OilSlick/soil_sensor_socr/.github/images/calibrating.jpeg

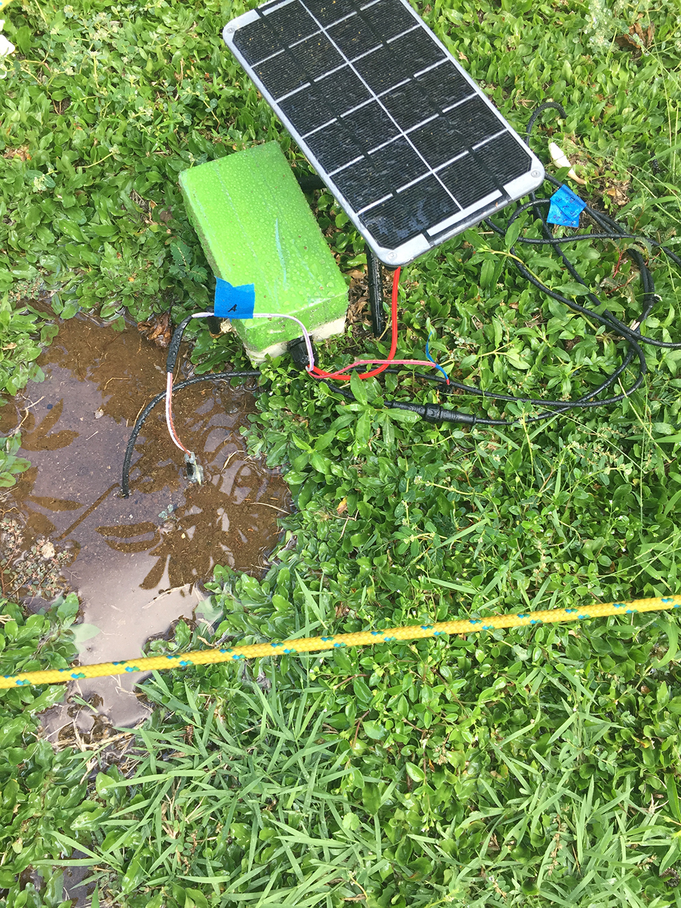
.github/images/calibrating.jpeg
