OilSlick/soil_sensor_socr/.github/images/calibrating1.jpeg

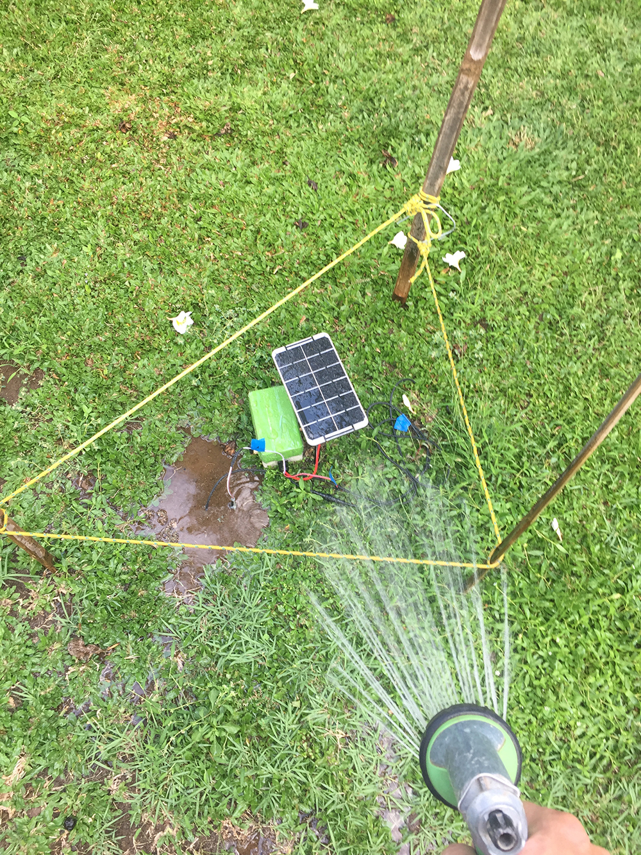
.github/images/calibrating1.jpeg
