OilSlick/soil_sensor_socr/.github/images/corrosion1.jpeg

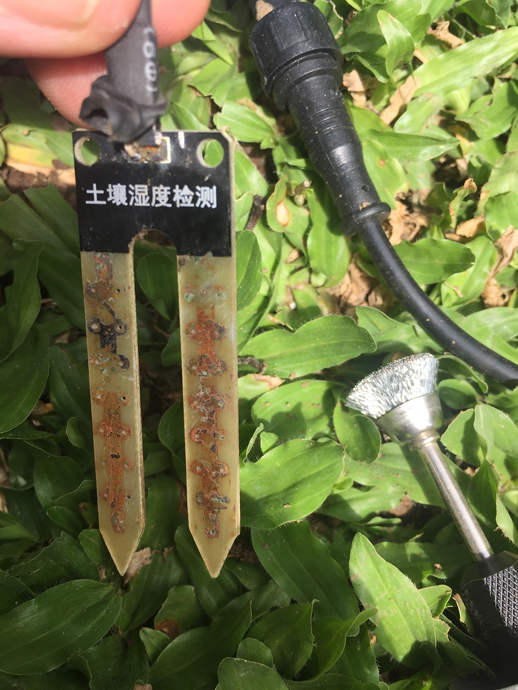
.github/images/corrosion1.jpeg
