OilSlick/soil_sensor_socr/.github/images/corrosion.jpeg

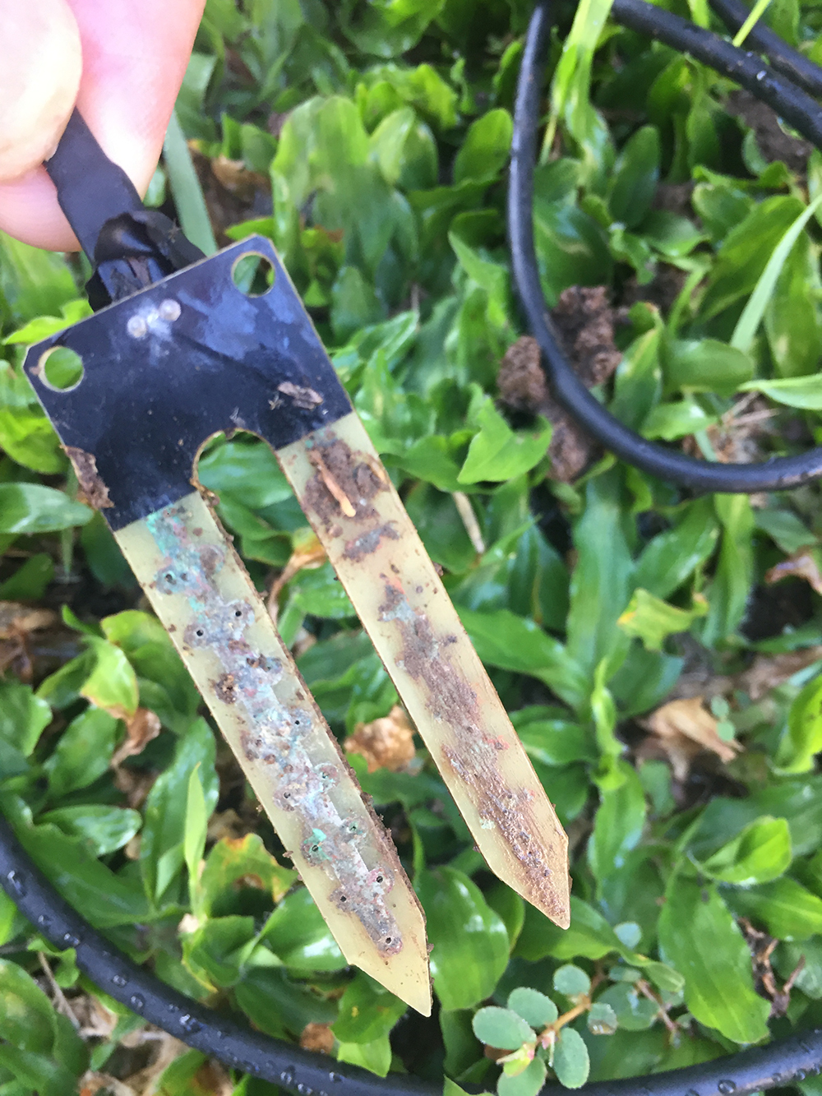
.github/images/corrosion.jpeg
