OilSlick/soil_sensor_socr/.github/images/heat.jpeg

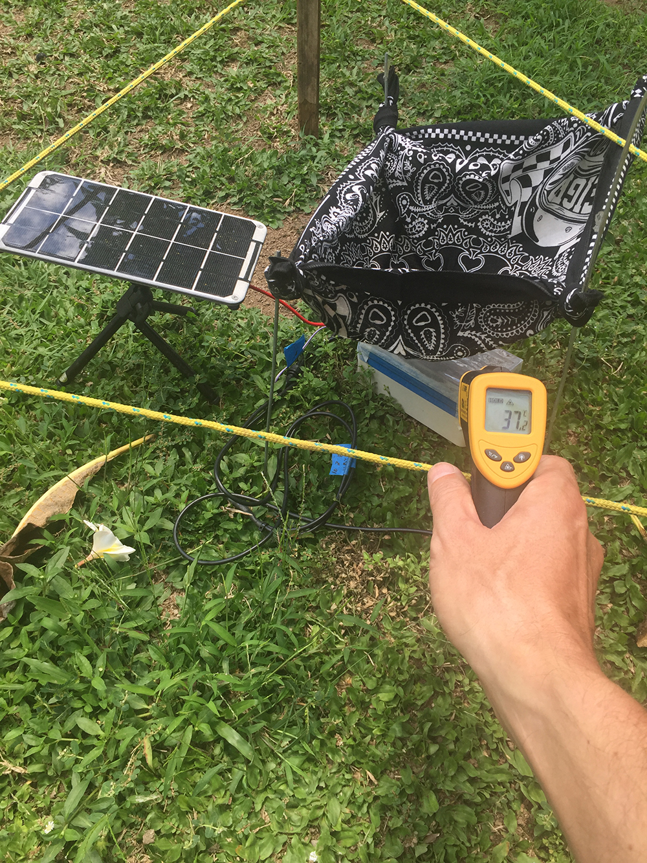
.github/images/heat.jpeg
