OilSlick/soil_sensor_socr/.github/images/over-voltage.png

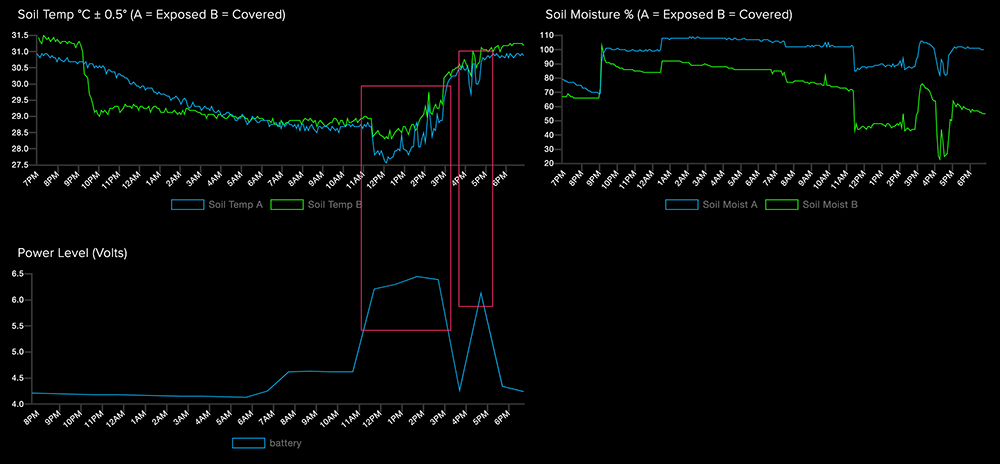
.github/images/over-voltage.png
