OilSlick/soil_sensor_socr/.github/images/probe-post1.jpeg

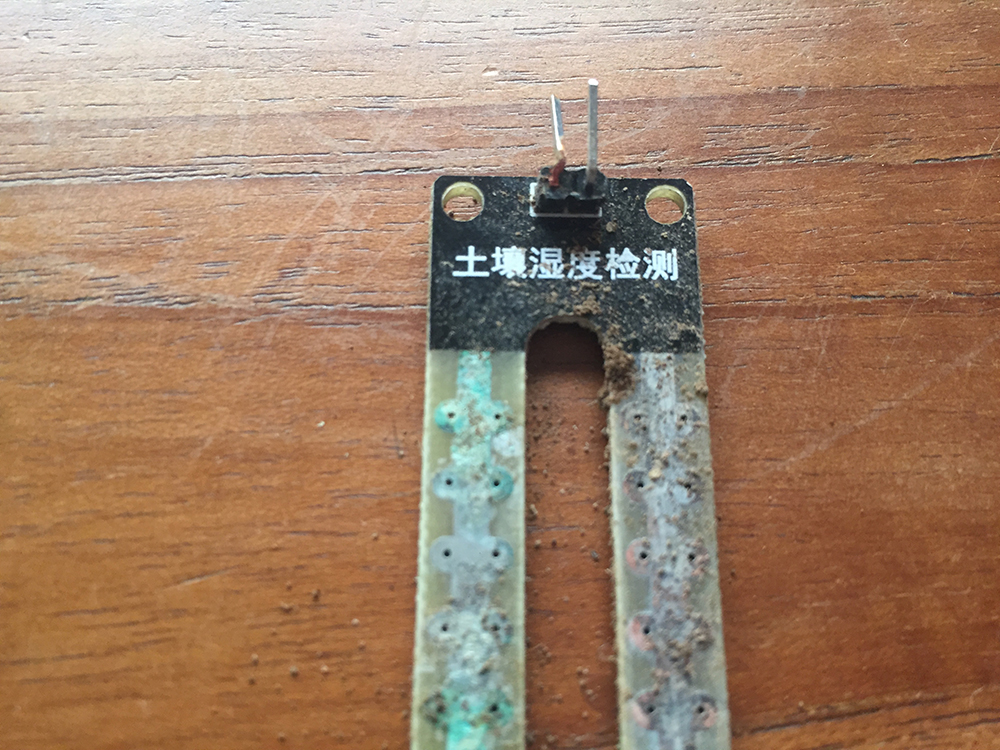
.github/images/probe-post1.jpeg
