OilSlick/soil_sensor_socr/.github/images/probe-post.jpeg

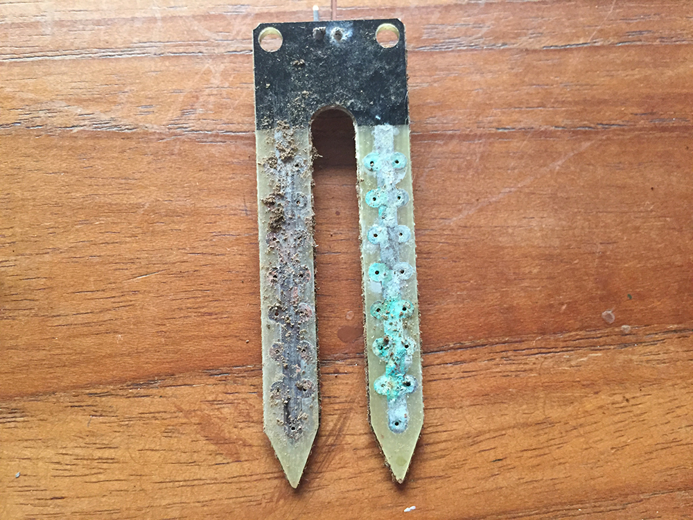
.github/images/probe-post.jpeg
