OilSlick/soil_sensor_socr/(threads)

Thread 1 (2020-03-20):

Reduce LoRa transmission

OilSlick, 2020-03-20:
Consider combining temp and moisture data tx into one, such as Temp and Moist A data as one transmission.

Transmission increases (almost doubles) the power consumption.

OilSlick, 2020-03-22:
I could also reduce the 12-byte payload being sent, as the temperature data is only 2 of those 12 bytes.

But I don't think I'll do either, because that would require me to take the sensor out of production to make the changes and that will affect data-collection and since this is a school project and the data is what I need, I'll likely just leave it as-is.

OilSlick, 2020-04-02:
I've decided to leave the transmissions as-is for now to 1) save time and get some freakin' data and 2) I would need to re-do how the web-gateway receives and interprets the data.

I may revisit this later, if I chose to deploy something like this sensor long-term (this is for a school project and won't necessarily be  needed after the semester is over.

Closed 2020-04-02.

Thread 3 (2020-03-26):

Check for reasonable values, discard unreasonable values

OilSlick, 2020-03-26:
Make sure all returned sensor values are within reasonable ranges and if not, discard them before transmitting.

OilSlick, 2020-03-29:
Just read about constrain() on this forum: https://forum.arduino.cc/index.php?topic=330634.0

https://www.arduino.cc/reference/en/language/functions/math/constrain/

OilSlick, 2020-04-02:
Have applied constrain() at the web gateway to all four probes, before it sends data to io.Adafruit

Closed 2020-04-02.

Thread 4 (2020-03-30):

Hardware: with full sun the unit reports erratic readings

OilSlick, 2020-03-30:
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

With full sun (and a full 6v from the solar panel) the values from all four sensors become erratic and generally lower.

Providing shade for the unit as a test point strongly towards over-power as the likely cause.

See also: [this Twitter thread](https://twitter.com/OilSlickCoffee/status/1243020344031473665?s=20)

OilSlick, 2020-04-02:
Installed an LM4931 LDO regulator between the LiPo charger and the microcontroller. That corrected the problem.

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

Closed 2020-04-02.

Thread 5 (2020-05-02):

Water damage

OilSlick, 2020-05-02:
It's a sad day. The station stopped reporting yesterday morning shortly after 5a. After troubleshooting everything else, I opened the unit to find it had water in it and the LiPo charger was sitting in water.

I'm pretty sure the water got in at the cable gland. I did a good job of sealing everything with hot glue, but not the actual cables where they pass through the gland. So with the relatively harsh environment of direct, tropical sun all day and the occasional monsoon overnight (we had two good storms as I recall while the unit was deployed.

And to add while I had the unit out of the ground I checked the last functioning moisture probe and found that it was also significantly corroded to the point of inaccurate readings.

So after I let everything dry out, I'll remove the moisture sensors and see what is salvageable from the unit. I hope to redeploy it to a different location in the yard, just with better waterproofing this time.

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
