OilSlick/soil_sensor_socr/transmissions.ino

void broadcastdata(byte data[], int sizeofFullPayload, byte ProbeAddr) {
  delay(200);                           // may be needed?
  LoRa.beginPacket();                   // start packet
  LoRa.write(destination);              // add destination address
  LoRa.write(localAddress);             // add sender address
  LoRa.write(msgCount);                 // add message ID
  LoRa.write(sizeofFullPayload);        // add payload length
  LoRa.write(ProbeAddr);                // Probe Address
  LoRa.write(data, sizeofFullPayload);  // add payload
  LoRa.endPacket();                     // finish packet and send it
  msgCount++;                           // increment message ID
  memset(data, 0, sizeof(data)); //clear array

//  if ( debug == true && Serial ) displayDebug("broadcastMessage()");
  digitalWrite(RFM95_SS, HIGH);

  if ( Serial && debug == 1 )
  {
    Serial.println(" ");
    Serial.print("Size of payload after TX: ");
    Serial.println(sizeofFullPayload);
    Serial.print("Payload after TX: ");
  
    for ( i = 0; i < sizeofFullPayload; i++) 
        {
          Serial.print(data[i], HEX);
          Serial.print(" ");
        }
    Serial.println(" ");
  }
}
