OilSlick/soil_sensor_socr/(commit log)

2020-03-19 Add millis timer
2020-03-19 slow things down a bit
    Need to delay transmissions to allow for the data to get from this sensor to the web gateway for processing then transmitted to io.adafruit
2020-03-21 remove power pin
2020-03-21 create function checking moisture and send raw data (issue #2)
    [soil_sensor_socr.ino]
2020-05-04 Sensor offline
